ZiZao3/RAS/组装.SLDASM

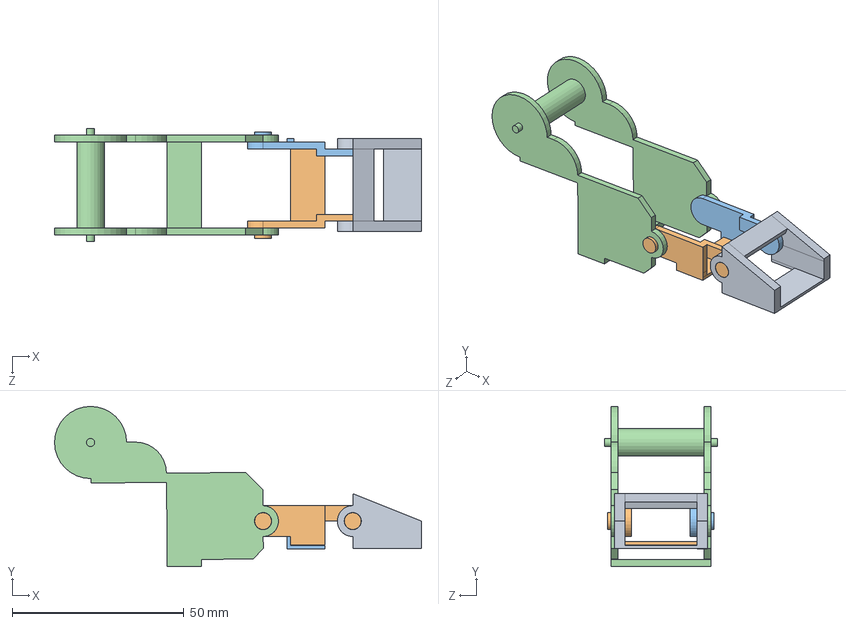
[picture p33: CAD file, 2023-06-23]
组装.SLDASM
106.8 x 46.6 x 33.0 mm
指头
中指节右
中指节左
后指头左
