ZiZao3/RAS/后指头左.SLDPRT

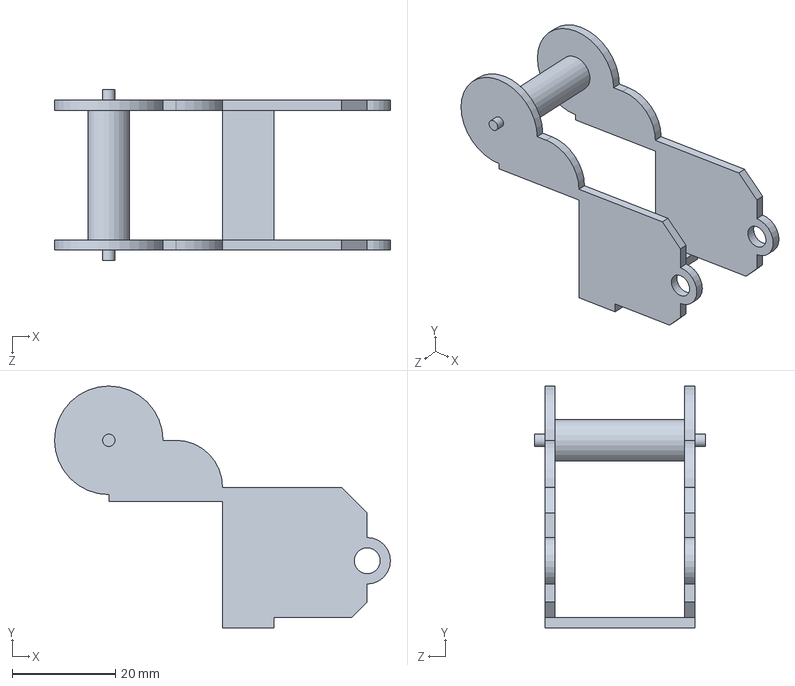
[picture p34: CAD file, 2023-06-23]
后指头左.SLDPRT
65.0 x 46.8 x 33.0 mm
