ZiZao3/RAS/中指节左.SLDPRT

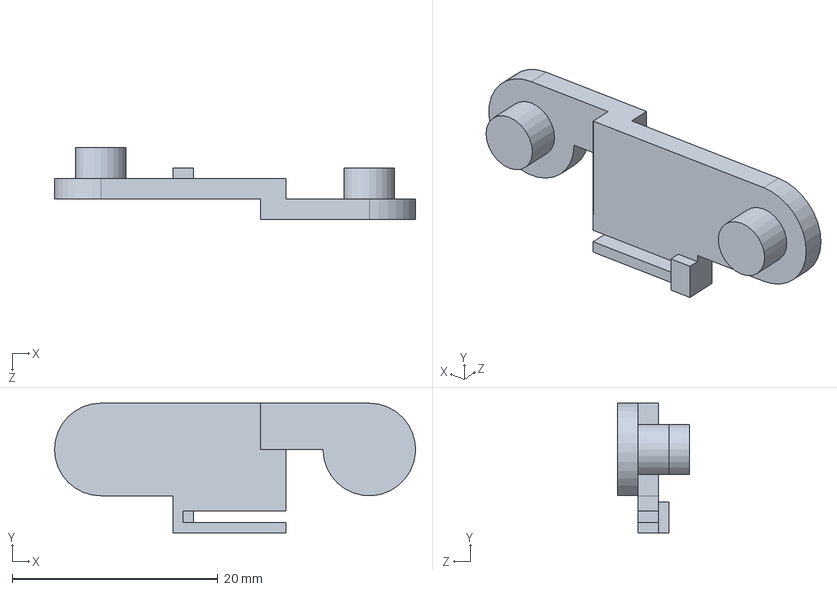
[picture p35: CAD file, 2023-06-23]
中指节左.SLDPRT
35.1 x 12.6 x 7.00 mm
