ZiZao3/RAS/指头.SLDPRT

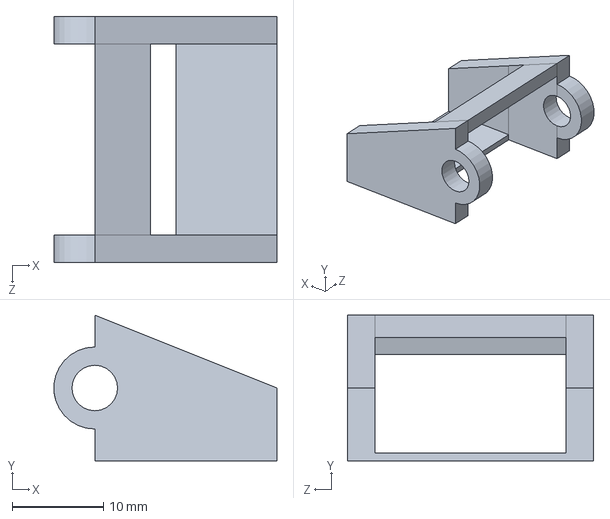
[picture p36: CAD file, 2023-06-23]
指头.SLDPRT
24.5 x 16.0 x 27.0 mm
