ZiZao3/RAS/底座.SLDPRT

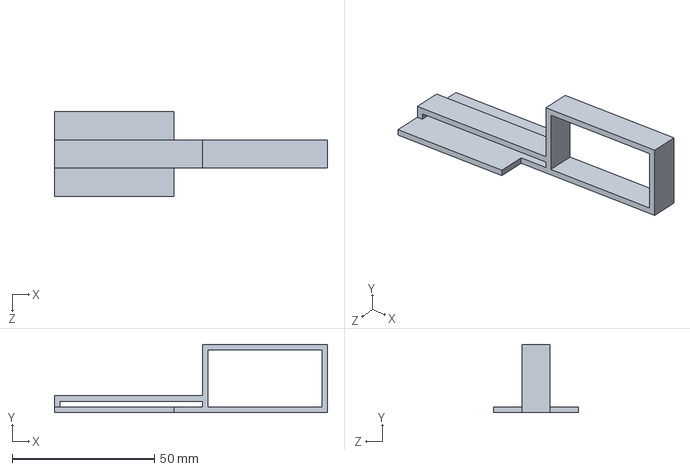
[picture p37: CAD file, 2023-06-23]
底座.SLDPRT
96.0 x 24.0 x 30.0 mm
