ZiZao3/RAS/中指节右.SLDPRT

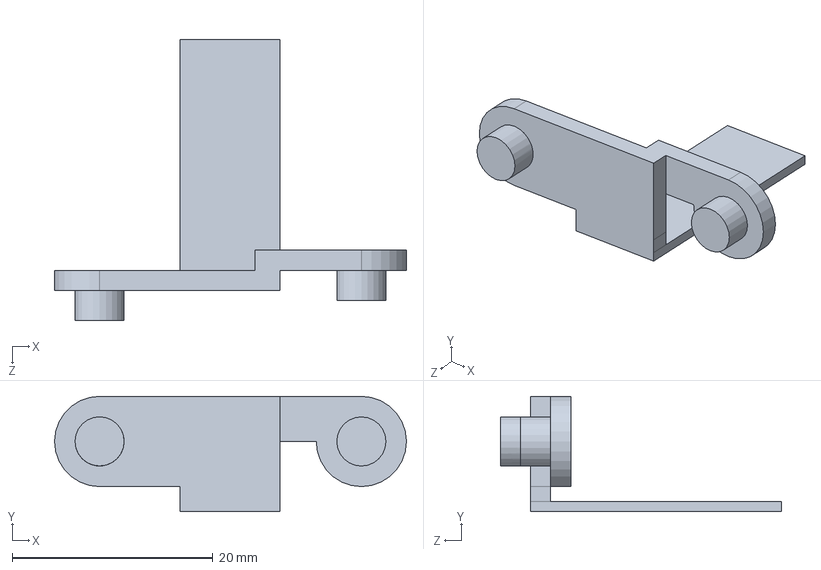
[picture p38: CAD file, 2023-06-23]
中指节右.SLDPRT
35.1 x 11.5 x 28.0 mm
